vladiclick/greenarm-robot-arm/CleanArm-01/CleanArm-01-notes.md

# CLEANARM 01 — concept CAD

Creat în Autodesk Fusion, 22 octombrie 2026.

## Ce conține

- 6 componente de ansamblu, 4 articulații rotative CAD și o legătură rigidă.
- Bază de 144 mm diametru, umăr la 92 mm, segmente de 120 și 110 mm între axe.
- Design exterior alb/grafit, capace de articulații și clește paralel conceptual.
- Configurație vizată: NEMA 17 la bază, cot și încheietură; NEMA 23 la umăr; servo la clește.
- Fișierul F3D păstrează componentele, schițele, operațiile și articulațiile. STEP este exportul geometric.

## Stadiul mecanic

Acesta este un concept de aspect și amplasare, nu un ansamblu gata de fabricat.
Carcasele motoarelor și reductoarelor sunt volume rezervate. Mecanismele cicloidale,
transmisiile, prinderile motoarelor, locașurile rulmenților, șuruburile, opritoarele,
cablajul și acționarea efectivă a cleștelui nu sunt finalizate.
Unele carcase sunt corpuri solide de concept, nu piese golite și pregătite pentru printare.
Nu a fost efectuată o verificare completă a coliziunilor pe toată cursa.

Ținta de 500 g, precizia de 1 mm, viteza, fluiditatea și încadrarea în 1.000 lei nu sunt validate.
Parametrii de lungime din tabelul Fusion sunt referințe nominale; nu comandă automat
toate schițele. Geometria se poate edita în timeline sau regenera din script.

## Verificare efectuată

Generatorul a rulat cu succes în Fusion. Ultima rulare: 6 componente, 5 legături,
fără avertismente în generator și fără operații cu stare de eroare/avertisment în timeline.
Aspectul a fost inspectat în viewport și în imaginea exportată.

## Următoarea etapă de inginerie

Se fixează sarcina, viteza și lista componentelor, se calculează cuplul dinamic și
masa proprie, apoi se proiectează și se testează o articulație de umăr. După aceea
se definitivează reductoarele, toleranțele, prinderile și separarea pieselor pentru printare.
