vladiclick/greenarm-robot-arm/GreenArm-02/Budget.md

# GreenArm 02 — controlul plafonului de 1.000 lei

Verificare: 22 octombrie 2026. Nu s-au cumpărat piese. Acest document separă prețurile publice de alocările de proiectare. Modelul CAD actual NU are încă un coș de cumpărături confirmat sub 1.000 lei.

## Repere publice

| Piesă | Cantitate CAD | Preț public | Subtotal |
|---|---:|---:|---:|
| [17HS16-2004S1, STEPPERONLINE](https://www.omc-stepperonline.com/nema-17-bipolar-45ncm-64oz-in-2a-42x42x40mm-4-wires-w-1m-cable-connector-17hs16-2004s1) | 3 | 9,13 USD | 27,39 USD |
| [NEMA23 23HS30-2804S](https://www.omc-stepperonline.com/nema-23-bipolar-1-8deg-1-9nm-269oz-in-2-8a-3-2v-57x57x76mm-4-wires-23hs30-2804s) | 1 | 18,26 USD din China; supliment pentru depozit Germania | 18,26 USD |
| Kit NEMA23 + DM542T, legat pe aceeași pagină STEPPERONLINE | 1, alternativ la motorul separat | de la 29 USD | 29 USD |
| [TMC2209 v1.3 UART](https://piese3d.ro/driver-tmc2209-v13-uart) | 3 | 36 lei | 108 lei |
| [DM542, variantă locală](https://ardushop.ro/ro/cnc/1712-driver-motor-pas-cu-pas-dm542-6427854025784.html) | 1, alternativ la kit | 143,75 lei, TVA inclus | 143,75 lei |
| [623ZZ](https://piese3d.ro/rulmenti) | 24 | 2,50 lei | 60 lei |
| [693 ZZ RUL](https://www.rul-grup.ro/rulment-693-zz-rul-67035) | 24 | 3 lei | 72 lei |
| [6806 2RS EZO](https://www.rulmenticamion.ro/en-gb/ezo-en-gb/) | 4 | 33,41 lei | 133,64 lei |
| [PLA Green Marble Mojito](https://epicrafting.ro/products/filament-3d-pla-green-marble-marmura-verde-mojito) | 1 rolă dacă nu există deja | reper 100 lei/kg | 100 lei |

Stocul TMC2209 diferă între pagina produsului și categoria magazinului; trebuie confirmat înainte de alegerea coșului. Nu se consideră garantat. Oferta de rulmenți este un reper de cost, nu o certificare de calitate sau precizie.

Prețurile USD nu includ automat transportul, taxele sau suplimentul depozitului. Nu se adună în lei folosind un curs prezentat drept curs bancar. Pentru o simulare conservatoare se poate folosi un **curs de buget de 5 lei/USD**, exclusiv ca ipoteză de proiectare.

## Ce mai trebuie inclus

- Servo ST3215: alocare preliminară 100–140 lei; varianta electrică exactă și oferta livrată nu sunt încă blocate.
- 2 × 6801, 2 × 6800 pentru excentrice; 1 × 6004 și 1 × 6001 pentru bază/încheietură.
- Sursă 24 V, alimentare separată potrivită variantei ST3215, controler, conexiuni și senzori de referință.
- Patru curele, opt fulii, tensionare, șuruburi, pinii și axele metalice, patru plăci de montaj pentru motoare.
- Filament alb și materialul pentru discurile funcționale, eventual răcire, transport și piese de probă.

Pentru aceste elemente încă necotate complet, o rezervă de 300–500 lei este **estimare de proiectare**, nu ofertă de magazin. Cumpărarea a două role întregi are alt cost decât consumul de material dacă rolele există deja.

## Concluzie de proiectare

Cu reperele de mai sus și două role alocate la 200 lei în total, simularea cu kitul NEMA23 de 29 USD ajunge la aproximativ **1.300–1.600 lei**, în funcție de piesele auxiliare și transport. Este o estimare, nu un preț final.

Așadar, varianta detaliată actuală nu este declarată soluția finală de 1.000 lei. Plafonul rămâne 1.000 lei; înainte de fabricație trebuie ales un coș livrat sub plafon sau simplificată transmisia. Posibile economii de verificat: furnizare comună a rulmenților și electronicii, folosirea filamentului existent, reducerea pieselor metalice prelucrate și reproiectarea rolelor. Nu se elimină rulmenți sau se schimbă motorul în tăcere: orice modificare cere actualizarea geometriei și verificarea jocului/încălzirii.
