vladiclick/greenarm-robot-arm/CleanArm-01/CleanArm-01-preview.png

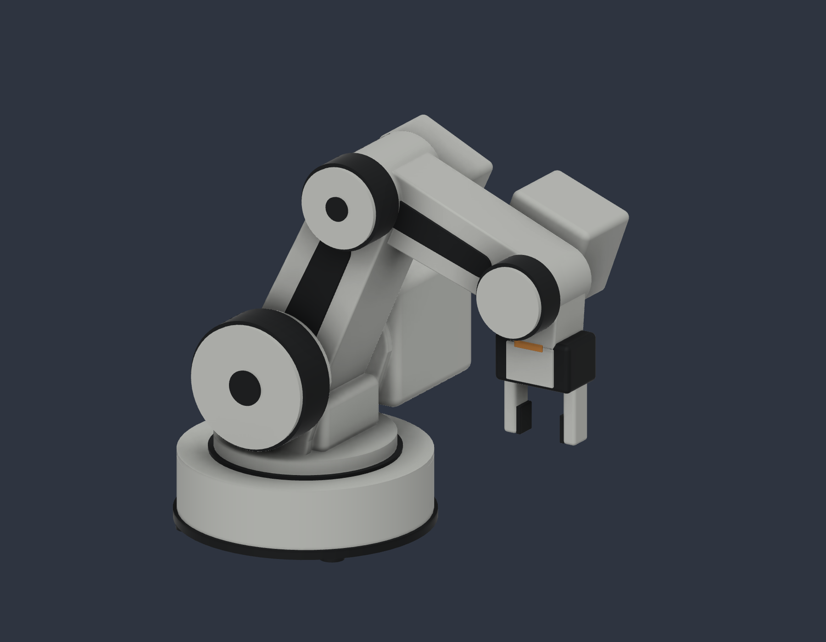
CleanArm-01/CleanArm-01-preview.png
