vladiclick/greenarm-robot-arm/GreenArm-02/GreenArm-02-internal.png

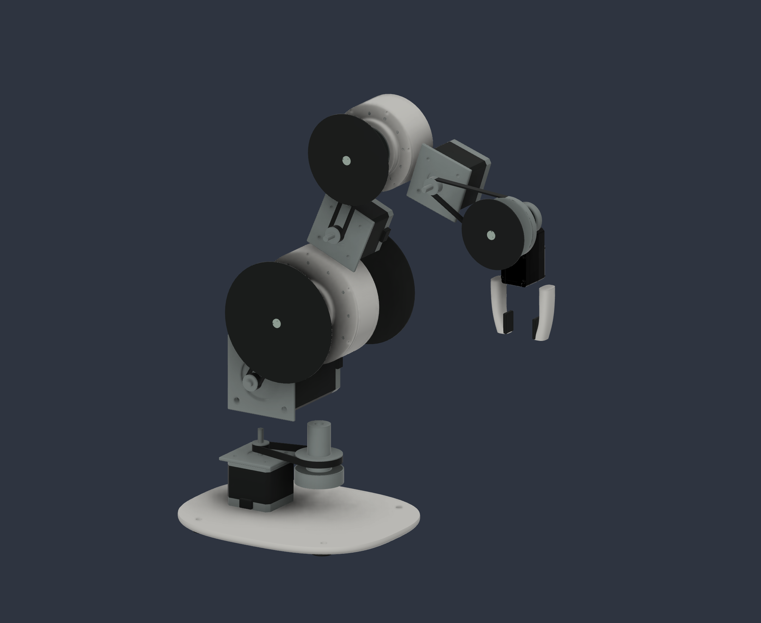
GreenArm-02/GreenArm-02-internal.png
