vladiclick/greenarm-robot-arm/GreenArm-02/GreenArm-02-rear.png

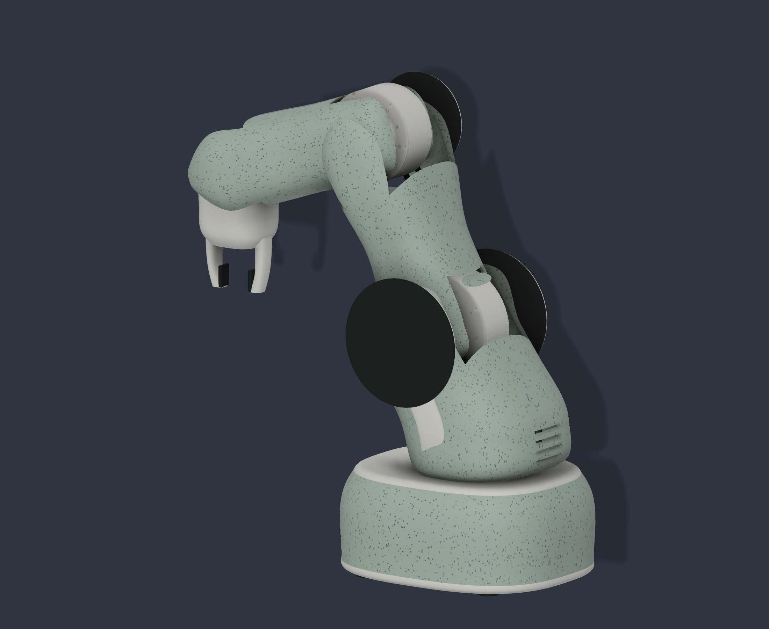
GreenArm-02/GreenArm-02-rear.png
