vladiclick/greenarm-robot-arm/GreenArm-02/Shoulder-cycloidal-cutaway.png

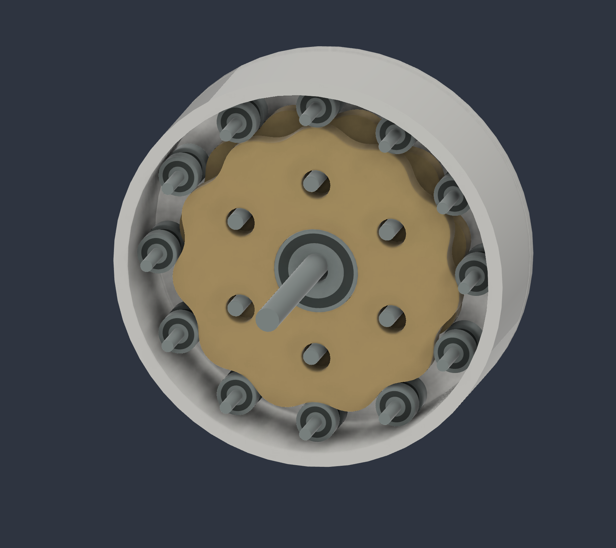
GreenArm-02/Shoulder-cycloidal-cutaway.png
