vladiclick/greenarm-robot-arm/GreenArm-03/GreenArm-03-front.png

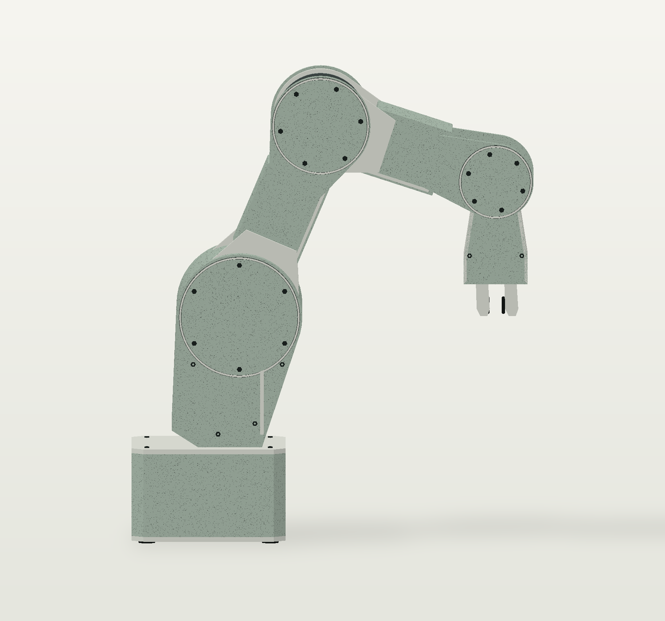
GreenArm-03/GreenArm-03-front.png
