vladiclick/greenarm-robot-arm/GreenArm-03/GreenArm-03-internal.png

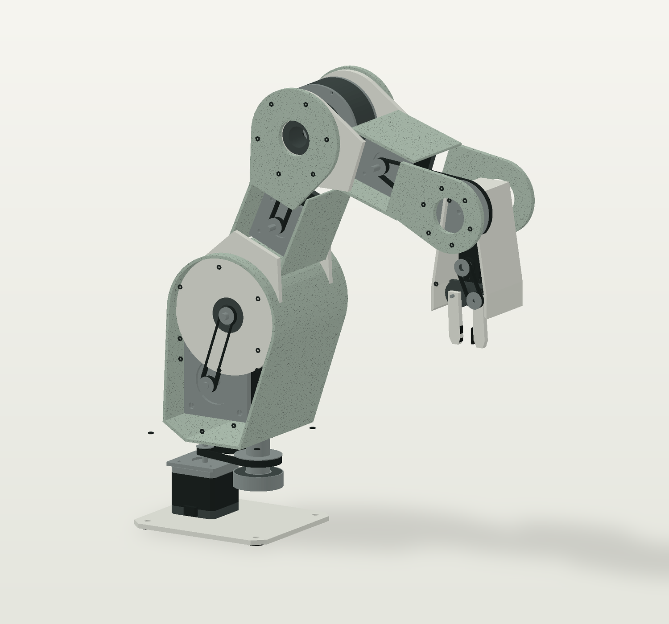
GreenArm-03/GreenArm-03-internal.png
