vladiclick/greenarm-robot-arm/GreenArm-02/materials/green-marble-albedo.png

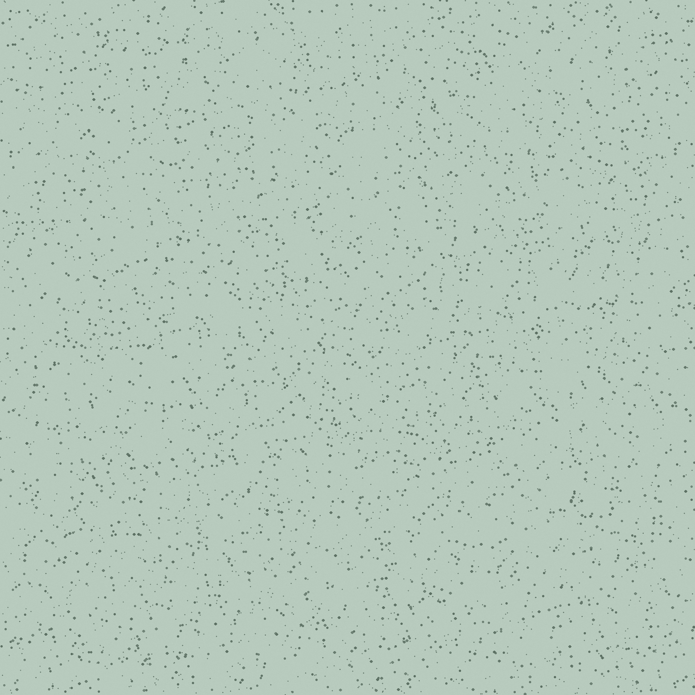
GreenArm-02/materials/green-marble-albedo.png
