vladiclick/greenarm-robot-arm/CleanArm-01/CleanArm-01.step

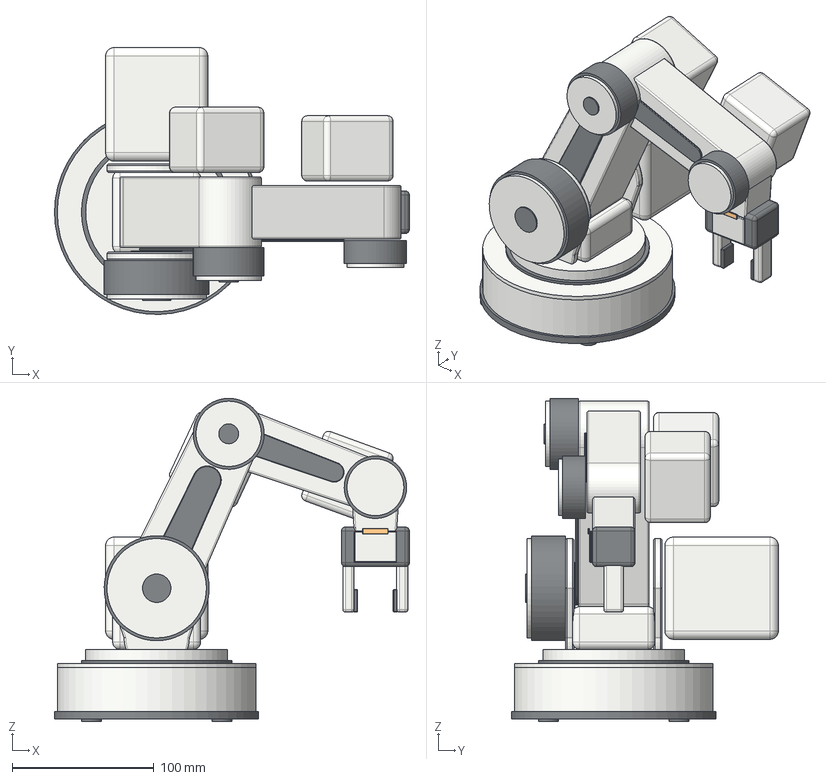
[picture p9: CAD file, 2026-10-26]
CleanArm-01/CleanArm-01.step
250.1 x 188.0 x 227.8 mm
