vladiclick/greenarm-robot-arm/GreenArm-02/Shoulder-cycloidal-11to1.step

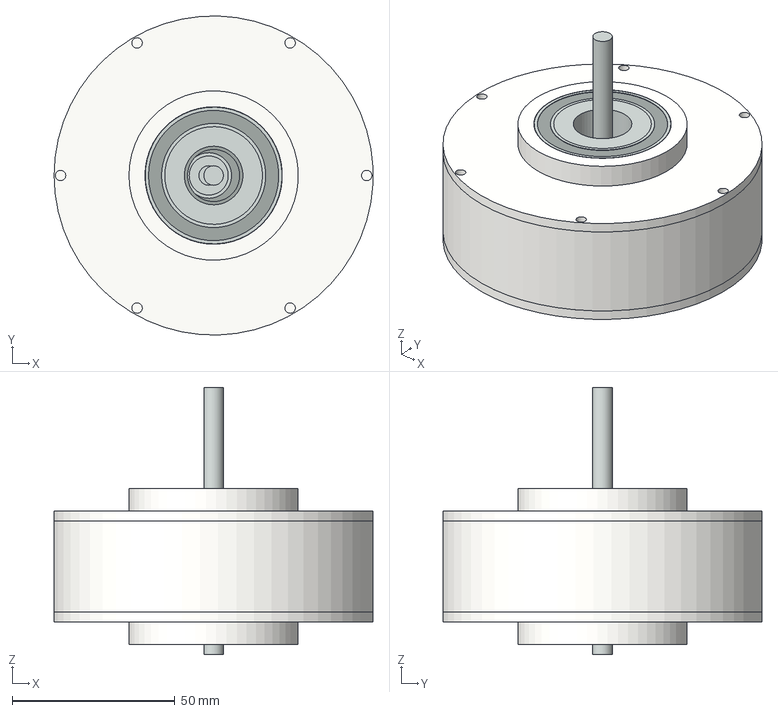
[picture p10: CAD file, 2026-10-26]
GreenArm-02/Shoulder-cycloidal-11to1.step
97.9 x 98.0 x 82.0 mm
