vladiclick/greenarm-robot-arm/GreenArm-03/GreenArm-03.step

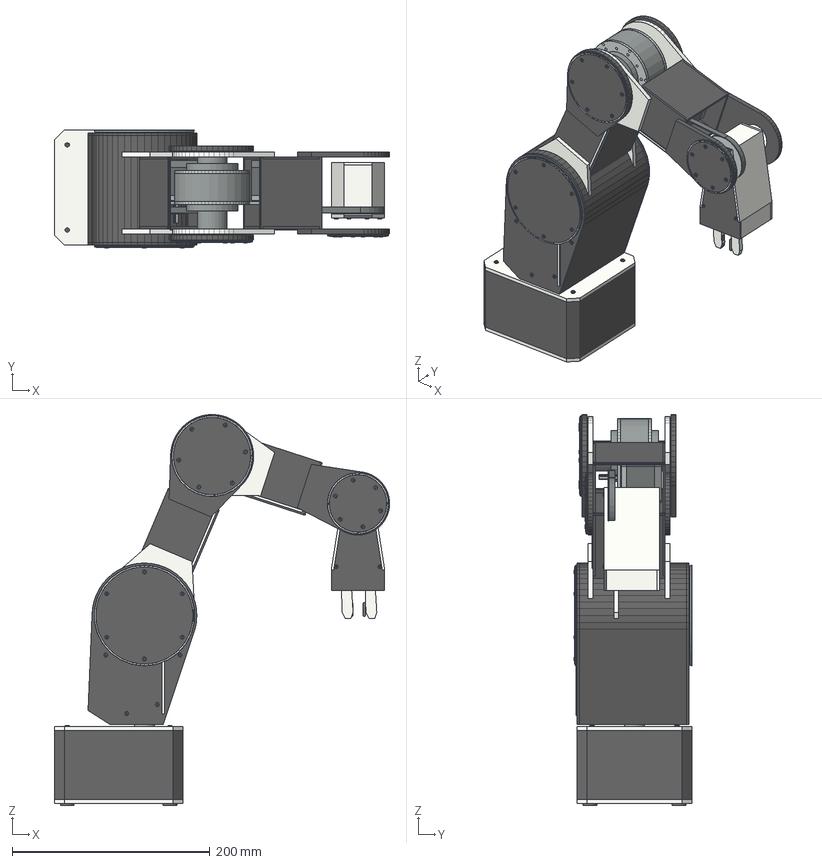
[picture p11: CAD file, 2026-10-26]
GreenArm-03/GreenArm-03.step
338.7 x 119.2 x 395.1 mm
