vladiclick/greenarm-robot-arm/(list of files, cad)

Other CAD files:
CleanArm-01/CleanArm-01.f3d
GreenArm-03/GreenArm-03.f3d
