vladiclick/greenarm-robot-arm/GreenArm-02/GreenArm-02-assembled.png

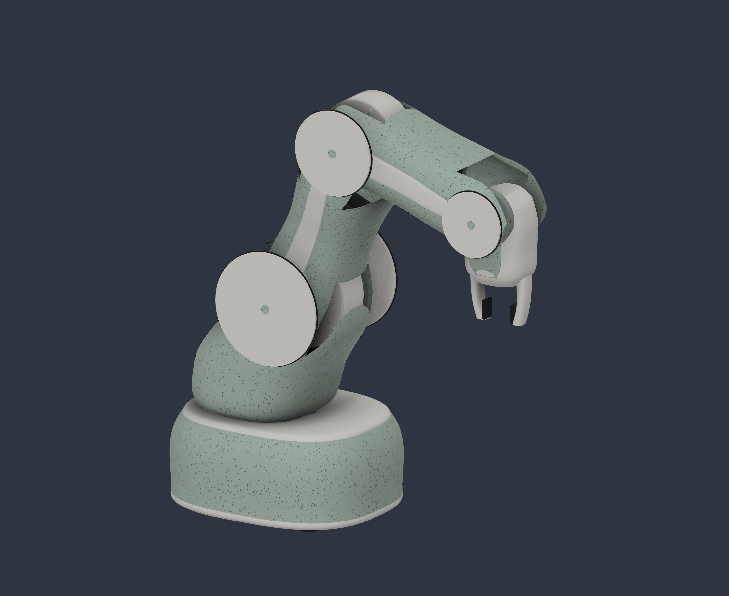
GreenArm-02/GreenArm-02-assembled.png
